zowen22/8.-Magic-Band/PCB/MagicBand_BarrelJack/drc_report.txt

** Drc report for MagicBand_BarrelJack.kicad_pcb **
** Created on 2026-08-13T00:49:16 **
** Report includes: Errors, Warnings **

** Found 4 DRC violations **
[starved_thermal]: Thermal relief connection to zone incomplete (layer B.Cu; 1 spokes connected to isolated island)
    Local override; error
    @(0.5000 mm, 0.5000 mm): Zone [GND] on B.Cu, priority 0
    @(26.5000 mm, 18.7200 mm): PTH pad 8 [GND] of U1
[lib_footprint_issues]: Footprint 'MountingHole_4.2mm' not found in library 'MountingHole'
    Local override; warning
    @(4.5000 mm, 34.5000 mm): Footprint MH2
[lib_footprint_issues]: Footprint 'MountingHole_4.2mm' not found in library 'MountingHole'
    Local override; warning
    @(35.0000 mm, 34.5000 mm): Footprint MH3
[lib_footprint_issues]: Footprint 'MountingHole_4.2mm' not found in library 'MountingHole'
    Local override; warning
    @(4.5000 mm, 5.0000 mm): Footprint MH1

** Found 0 unconnected pads **

** Found 0 Footprint errors **

** Ignored checks **
    - Footprint has no courtyard defined
    - Track endpoint not centered on via
    - Tuning profile track geometries
    - Footprint doesn't match symbol's footprint filters
    - Footprint component type doesn't match footprint pads

** End of Report **
