zowen22/8.-Magic-Band/1. Project Management/4. Technical Reference.md

# Technical Reference

*Last updated: 2026-08-10*

-----

## Hardware

| Component | Part | Notes |
|---|---|---|
| Microcontroller | Arduino Nano (ATmega328P) | Compact, fits in ornament; same pin numbers as Uno |
| RFID Reader | MFRC522 | SPI interface, 3.3V |
| NeoPixels | LED strip — count TBD (strip on order) | Pin 5, NEO_GRB, 5V |
| RF Transmitter | 433MHz transmitter module | Pin 8, ~$1, replaces relay entirely |
| RF Outlet | Etekcity or similar 433MHz outlet | Pre-paired before shipping; buyer plugs into wall |
| Audio | DFPlayer Mini + 8Ω 1W speaker | Pins 2/3 SoftwareSerial |
| MicroSD | Any small card | Audio file as 001.mp3 |
| Power input | 5.5mm/2.1mm panel-mount barrel jack | Mounts in ornament shell, wires to Nano VIN + GND |
| Power supply | 5V 3A wall adapter, barrel jack output | Buyer-supplied or included; standard commodity |

**One-time tooling (your bench only):**
| Component | Part | Notes |
|---|---|---|
| RF Sniffer | 433MHz receiver module | Used once to capture outlet remote codes |

## Pin Map (Nano)

| Pin | Function |
|---|---|
| 2 | DFPlayer RX (Arduino TX → player) |
| 3 | DFPlayer TX (player TX → Arduino) |
| 4 | MFRC522 SS |
| 5 | NeoPixel LED strip |
| 6 | *(unused — was inner ring, removed 2026-08-06)* |
| 8 | RF transmitter DATA |
| 9 | MFRC522 RST |
| 11 | SPI MOSI |
| 12 | SPI MISO |
| 13 | SPI SCK |
| 3V3 | MFRC522 VCC |
| VIN | Barrel jack center (positive) |
| GND | Barrel jack sleeve + common ground |

## Libraries

| Library | Purpose | Install via |
|---|---|---|
| MFRC522 | RFID reader | Library Manager |
| Adafruit NeoPixel | LED rings | Library Manager |
| rc-switch (sui77) | 433MHz RF transmit/receive | Library Manager |
| DFRobotDFPlayerMini | Audio player | Library Manager |
| SoftwareSerial | DFPlayer serial | Built-in |
| SPI | RFID SPI bus | Built-in |

## Sketches

| File | Purpose |
|---|---|
| `Revisions/Sniffer/Sniffer.ino` | One-time: captures RF codes from outlet remote over Serial |
| `Revisions/Rev3/Rev3.ino` | Relay-based version (archived — superseded by Rev4) |
| `Revisions/Rev4/Rev4.ino` | **Current production sketch** — RF transmitter, no mains wiring |
| `MAGIC_BAND_FINAL/` | Original working sketch (archived reference) |

## Enclosure Notes

- Ornament shell: 3D printed
- Barrel jack: 5.5mm/2.1mm panel-mount, requires **11mm hole** in shell
- Orient jack on bottom — cable exits downward, follows ornament wire naturally
- Minimum 15mm clearance behind jack inside shell for solder tabs + wiring
- Nano footprint: 18mm × 45mm — plan mounting accordingly

## RF Workflow (per unit)

1. Run `Sniffer.ino` with receiver on pin 2 — press all remote buttons, record codes
2. Fill `RF_CODE_ON`, `RF_CODE_OFF`, `RF_BITS`, `RF_PROTOCOL` in Rev4
3. Flash Rev4, put outlet in learn mode, scan any RFID card to pair
4. Confirm outlet responds, ship pre-paired

## Known Constraints / Gotchas

- Nano VIN accepts 7–12V regulated but 5V works fine from a regulated supply
- MFRC522 is 3.3V — use Nano's 3V3 pin, not 5V
- DFPlayer audio file must be named `001.mp3` on the SD card root
- rc-switch `send()` is blocking — NeoPixel animations must complete before RF fires
- 433MHz is fire-and-forget (no ACK) — send code 5× to ensure reception (`RF_REPEAT`)
- Nano has Mini-USB for programming; power in production via VIN barrel jack

## Dev Environment Setup (WSL2 + Windows) — Full Recovery Runbook

If this WSL2 instance ever gets nuked, or you're setting up on a new machine, this is
the complete path from nothing to "flashing sketches from a WSL terminal." Assumes
Windows + WSL2/Ubuntu already installed — that part isn't covered here.

### 0. Checklist (tick off in order)

- [ ] Repo cloned into WSL via SSH (not HTTPS, not the Windows filesystem)
- [ ] `arduino-cli` installed + on PATH
- [ ] `arduino:avr` core installed
- [ ] Required libraries installed (MFRC522, Adafruit NeoPixel, rc-switch, DFRobotDFPlayerMini)
- [ ] `usbipd-win` installed on Windows
- [ ] `usbip` client tools + `dialout` group set up in WSL
- [ ] Board attached (`usbipd attach`) and visible (`arduino-cli board list`)
- [ ] KiCad installed (AppImage, extracted, `kicad-cli` on PATH)
- [ ] Global symbol/footprint library tables configured (one-time GUI first-launch step)

### 1. Repo access (SSH)

Repo is `git@github.com:zowen22/8.-Magic-Band.git` — SSH only. If this WSL instance
doesn't already have a deploy key set up on your GitHub account:
```bash
ssh-keygen -t ed25519 -C "zowen22@gmail.com"   # accept default path, empty passphrase is fine for a dev box
cat ~/.ssh/id_ed25519.pub                       # paste this into GitHub → Settings → SSH keys
ssh -T git@github.com                           # should greet you by username once the key's added
```
Then clone:
```bash
mkdir -p ~/projects && cd ~/projects
git clone git@github.com:zowen22/8.-Magic-Band.git "8.-Magic-Band"
```

### 2. Arduino toolchain

```bash
mkdir -p ~/.local/bin
curl -fsSL https://raw.githubusercontent.com/arduino/arduino-cli/master/install.sh | BINDIR=~/.local/bin sh
echo 'export PATH="$HOME/.local/bin:$PATH"' >> ~/.bashrc
export PATH="$HOME/.local/bin:$PATH"          # for the current shell too

arduino-cli config init
arduino-cli core update-index
arduino-cli core install arduino:avr

arduino-cli lib install "MFRC522" "Adafruit NeoPixel" "rc-switch" "DFRobotDFPlayerMini"
```
Sanity check — should compile clean with no board attached:
```bash
cd ~/projects/8.-Magic-Band
arduino-cli compile --fqbn arduino:avr:nano:cpu=atmega328old RF_Sniffer
```

### 3. USB passthrough (Windows ⇄ WSL2)

The board connects via USB to Windows and is **not** visible in WSL by default — needs
a bridge every time it's (re)connected.

**One-time, Windows (Admin PowerShell):**
```powershell
winget install usbipd
```

**One-time, WSL (regular interactive terminal — needs real sudo):**
```bash
sudo apt-get update
sudo apt-get install -y linux-tools-generic hwdata
sudo update-alternatives --install /usr/local/bin/usbip usbip /usr/lib/linux-tools/*-generic/usbip 20
sudo usermod -aG dialout $USER
```
After `usermod`, open a **new** terminal window — group membership doesn't apply
retroactively to the shell you ran it from (`newgrp dialout` also works if `newgrp`
happens to be installed; wasn't on this machine's minimal Ubuntu image, so a fresh
terminal was the actual fix used).

**Every time the board is (re)connected, or after a reboot — Windows (Admin PowerShell):**
```powershell
usbipd list                    # find the board's BUSID
usbipd bind --busid <BUSID>    # one-time per device, not per session
usbipd attach --wsl --busid <BUSID>
```
Our board enumerates as CH340, VID:PID `1a86:7523`. Keep that PowerShell window open —
the attach only holds while it's running (or use `usbipd attach -a` for auto-reattach).

**Then, WSL:**
```bash
arduino-cli board list   # should show /dev/ttyUSB0 once attached
```

### 4. Quick-reference commands

```bash
cd ~/projects/8.-Magic-Band/<sketch-folder>          # e.g. MagicBand_Wireless, RF_Sniffer, RF_TX_Test, MagicBand_v1
arduino-cli compile --fqbn <fqbn> .
arduino-cli upload -p /dev/ttyUSB0 --fqbn <fqbn> .
arduino-cli monitor -p /dev/ttyUSB0 -c baudrate=9600
```
FQBNs in use on this project:
| Board | FQBN |
|---|---|
| Nano (old bootloader — the spare bench board) | `arduino:avr:nano:cpu=atmega328old` |
| Pro Mini, 5V/16MHz (real wireless-variant target) | `arduino:avr:pro:cpu=16MHzatmega328` |

### 5. KiCad (PCB design)

No root/apt available in this sandbox — installed via the official AppImage, extracted
manually (no FUSE), not run in place.

```bash
mkdir -p ~/.local/opt && cd ~/.local/opt
# grab the current AppImage from https://www.kicad.org/download/linux/ — 10.0.5 is what's installed here
chmod +x kicad-10.0.5-x86_64.AppImage
./kicad-10.0.5-x86_64.AppImage --appimage-extract        # produces ./squashfs-root

mkdir -p ~/.local/bin
ln -s ~/.local/opt/squashfs-root/usr/bin/kicad-cli ~/.local/bin/kicad-cli
echo 'export PATH="$HOME/.local/bin:$PATH"' >> ~/.bashrc  # skip if already added in step 2
```
Launch the GUI — appears via WSLg automatically, no X server setup needed, **but force
software rendering** (see gotcha below, confirmed 2026-08-05):
```bash
LIBGL_ALWAYS_SOFTWARE=1 ~/.local/opt/squashfs-root/usr/bin/kicad
```
**First launch does one-time global library setup** — this is a real GUI-only step
(tracked as WP3.1, can't be done headlessly). KiCad will prompt to configure the global
symbol and footprint library tables; accept the defaults. Despite this being the "lite"
AppImage variant, both `usr/share/kicad/symbols` and `usr/share/kicad/footprints` **are**
bundled locally under `~/.local/opt/squashfs-root/` (verified 2026-08-05 — earlier notes
in this project claiming "no bundled footprint library" were wrong; no network fetch is
needed for standard parts).

`pymupdf` (Python) is already available in this environment, no separate install needed —
used to render datasheet PDFs to images locally for pin-diagram verification when
`poppler-utils`/`pdftoppm` isn't available (root-blocked, same constraint as everything
else here).

### 6. FreeRouting (autorouter)

Runs headless once you have a Specctra DSN file — but two steps around it are GUI-only in
KiCad 10.0.5 (no `kicad-cli` equivalent exists for either):
1. **DSN export**: `pcbnew` → File → Export → Specctra DSN
2. **Session re-import**: `pcbnew` → File → Import → Specctra Session (then **Fill Zones**
   again — the copper pour doesn't auto-recompute against newly-imported tracks/vias, and
   DRC will show a wave of bogus `0.0000mm` clearance violations until you refill)

**Setup (one-time):**
```bash
mkdir -p ~/.local/opt
# freerouting.jar (v2.2.4): https://github.com/freerouting/freerouting/releases
# needs a JRE with class file version >= 69 (Java 25) -- confirmed the error otherwise:
#   UnsupportedClassVersionError: ... compiled by a more recent version ...
# a JDK 17 JRE will NOT work. Grab a JDK 25 JRE (e.g. Eclipse Temurin) and extract to
# ~/.local/opt/jre25/
```
Both files must live under `~/.local/opt/` (or somewhere else persistent) — **not** `/tmp`,
which is ephemeral in this environment and won't survive a reboot/reset.

**Run:**
```bash
~/.local/opt/jre25/jdk-25.0.4+7-jre/bin/java -jar ~/.local/opt/freerouting-2.2.4.jar \
  -de "<board>.dsn" \
  -do "<board>.ses" \
  -mp 50 \
  --gui.enabled=false
```
`-de` = design (input DSN), `-do` = design output (session file), `-mp` = max passes.
Config/logs land in `/tmp/freerouting/` (`freerouting.json`, `freerouting.log`) — that's
FreeRouting's own default (`java.io.tmpdir`), fine to leave ephemeral, only the jar+JRE
need to persist. On the 40x40mm 2-layer board here: 42 unrouted nets → 0, 4 passes, ~2.5s.

**Gotcha (confirmed 2026-08-10):** despite running via CLI args, FreeRouting can still pop
up a GUI dialog (data-collection/review consent) when a display is reachable (WSLg here) —
this silently blocks the process between "routing complete" and actually writing the `.ses`
file, no CLI error, just a multi-minute hang until someone dismisses the popup by hand.

First attempted fix — editing `/tmp/freerouting/freerouting.json` to set
`gui.enabled`/`allow_telemetry`/`allow_contact` to `false` — **didn't hold**: the popup
itself writes its own values back to that file (GUI source, priority 50 in FreeRouting's
own settings-precedence ladder — see `docs/settings.md` in the freerouting repo), so it
silently reverted between runs. **The reliable fix is the `--gui.enabled=false` CLI flag**
shown above (priority 60, always beats the file and any GUI write-back). Always pass it
explicitly on every invocation rather than relying on the JSON file's persisted state.

### 7. Placement & Routing Workflow (end-to-end)

The full cycle used repeatedly on 2026-08-09/10, split by who does which half:

1. **User, in `pcbnew`:** move/place components as needed.
2. **User:** if the move was substantial (moved something that already had routing near
   it), select-all tracks/vias with the Selection Filter set to Tracks+Vias only, delete,
   then **Fill Zones (B)**. For a small/isolated move this step can often be skipped —
   FreeRouting will just re-route whatever's now broken and leave the rest alone.
3. **User:** File → Export → Specctra DSN, overwrite `<board>.dsn` in the same folder.
4. **User:** tell Claude "exported" (or similar).
5. **Claude:** run FreeRouting (see section 6 above for the exact command, always with
   `--gui.enabled=false`). Report the unrouted-net count before/after.
6. **User:** File → Import → Specctra Session, then **Fill Zones (B)** again (the pour
   doesn't auto-recompute against newly-imported copper), then save.
7. **Claude:** run `kicad-cli pcb drc`, regenerate `board_top.svg`/`board_bottom.svg`,
   commit + push to `main`, update Work Packages/Session Log.

**When FreeRouting can't finish some nets** (stalls at N unrouted, "board state has not
changed... cannot make further progress"): don't fight it with more passes, just finish
those specific nets by hand in `pcbnew` — usually faster and it's exactly what interactive
routing is for:
- Press **X** on a pad/net to start an interactive route, click to lay down segments.
- Press **V** *while still actively dragging* to drop a via and hop to the other copper
  layer at that point — the standard way around an obstacle on the current layer.
- To change an **existing** trace: select it and press **G** (drag, keeps connections
  intact — not **M**, which is a bare move and leaves the trace behind) then **V** mid-drag
  to hop layers, or for a trace whose both ends already land on a via/THT pad, just
  right-click → **Properties** and change the **Layer** field directly, no via needed.
- After a manual fix, re-export DSN and run FreeRouting again if you want it to pick up
  and finish anything else — it treats already-routed nets as done and only works on what's
  left (confirmed 2026-08-10: a re-run after a manual fix reported "started with 0 unrouted
  nets" and exited immediately).

**If a Specctra session import ever comes back corrupted/fails**, don't fight it: revert
the uncommitted `.kicad_pcb` (`git restore` back to the last commit, or File → Revert in
`pcbnew`) rather than trying to debug a broken `.ses` — cheaper to redo the move and
re-export than to chase corruption. Delete the stale `.dsn`/`.ses` too so there's no
confusion about which export is current.

### Dead ends — don't retry these

- **Launching KiCad under WSLg with default (hardware) OpenGL rendering** — symptom:
  window opens but appears frozen/unresponsive, and hovering over it makes the mouse
  cursor disappear entirely; clicks don't register. This is a WSLg GPU-passthrough
  rendering glitch (KiCad's canvas uses OpenGL, passed through to the Windows host GPU
  driver via WSLg's virtual GPU layer), not an app hang — confirmed by killing and
  relaunching with `LIBGL_ALWAYS_SOFTWARE=1`, which fixed it immediately (2026-08-05).
  **Always launch KiCad with that env var set** (see launch command above) until this is
  root-caused properly — likely candidates if it needs a permanent fix: `wsl --update`
  from an admin Windows PowerShell, or a Windows-side GPU driver update. Software
  rendering is slower but fine for a 40x40mm board.
- **Using "Update PCB from Schematic" (F8) on `MagicBand_BarrelJack`** — confirmed broken:
  the board's PCB footprints are missing the `path` attribute that links them back to their
  schematic symbol's UUID (likely from earlier direct `.kicad_pcb`/`.kicad_sch` S-expression
  edits that bypassed the normal netlist-import flow — see the placement-fix and J7-removal
  entries in `5. Session Log.md`). Without that link, F8 can't recognize any existing PCB
  footprint as already-placed, so it treats every schematic symbol as new and adds a
  duplicate footprint for each one, right on top of the originals (confirmed 2026-08-10,
  reverted without saving). For any future footprint swap on this board, use PCB-side
  **Change Footprint(s)...** directly (select the footprint, right-click) instead — it
  doesn't depend on the broken schematic linkage. F8 also first requires the schematic be
  annotated (Tools → Annotate Schematic, "keep existing annotations") even though every
  symbol already has a normal numbered reference — that's a separate, harmless prerequisite
  check, not related to the duplication bug.
- **Expecting a `pcbnew` Python module in this AppImage install** — confirmed absent (not
  assumed). Headless PCB scripting is limited to `kicad-cli`'s DRC/ERC/export subcommands
  plus direct `.kicad_pcb`/`.kicad_sch` S-expression text editing — no programmatic
  board-object API here.
- **Expecting `kicad-cli` to export Specctra DSN for autorouting** — not present in KiCad
  10.0.5; that export is GUI-only (`File → Export → Specctra DSN`). FreeRouting itself
  runs fine headless (portable JRE, no root needed), but there's no way to hand it a board
  without the GUI export step first. See "FreeRouting (autorouter)" above for the working
  headless recipe once you have a DSN in hand.
- **Running FreeRouting with whatever `java` happens to be on PATH** — this jar needs a
  JDK 25+ JRE specifically; anything older (confirmed: JDK 17) fails immediately with
  `UnsupportedClassVersionError`. See "FreeRouting (autorouter)" above.
- **Mapping `\\wsl$\...` as a network drive** (`net use`, `New-PSDrive -Persist`,
  Explorer's "Map Network Drive" wizard) — all fail with "network name no longer
  available," or loop on a credential prompt that goes nowhere. The share works fine for
  *browsing* in Explorer or passing a raw UNC path as a CLI argument — just not for
  persistent drive mapping.
- **Opening sketches in Arduino IDE via a `\\wsl$\...` path** — the IDE's file-open
  dialog silently creates a blank `sketch_xxxx` instead of loading the real file, even
  when the dialog itself accepted the path. Legacy Windows file APIs mishandling UNC
  paths, not a content problem. Drag-and-drop from an open Explorer window onto the IDE
  window works around it; better to just skip the IDE GUI entirely (step 4 above).
- **Doing any of this from a Claude Code background job** — those run in a locked-down
  container with its own synthetic `/dev` that doesn't include real hardware, even after
  a successful `usbipd attach`. The kernel genuinely does bind the board (visible in the
  WSL2 VM's own `dmesg`), but the job's container can't see it, and there's no
  permission or sudo that changes that — it's a mount-namespace boundary, not an access
  grant. Needs a real interactive WSL terminal, opened by you, not a background job.
