zowen22/8.-Magic-Band/PCB/MagicBand_BarrelJack/schematic.pdf

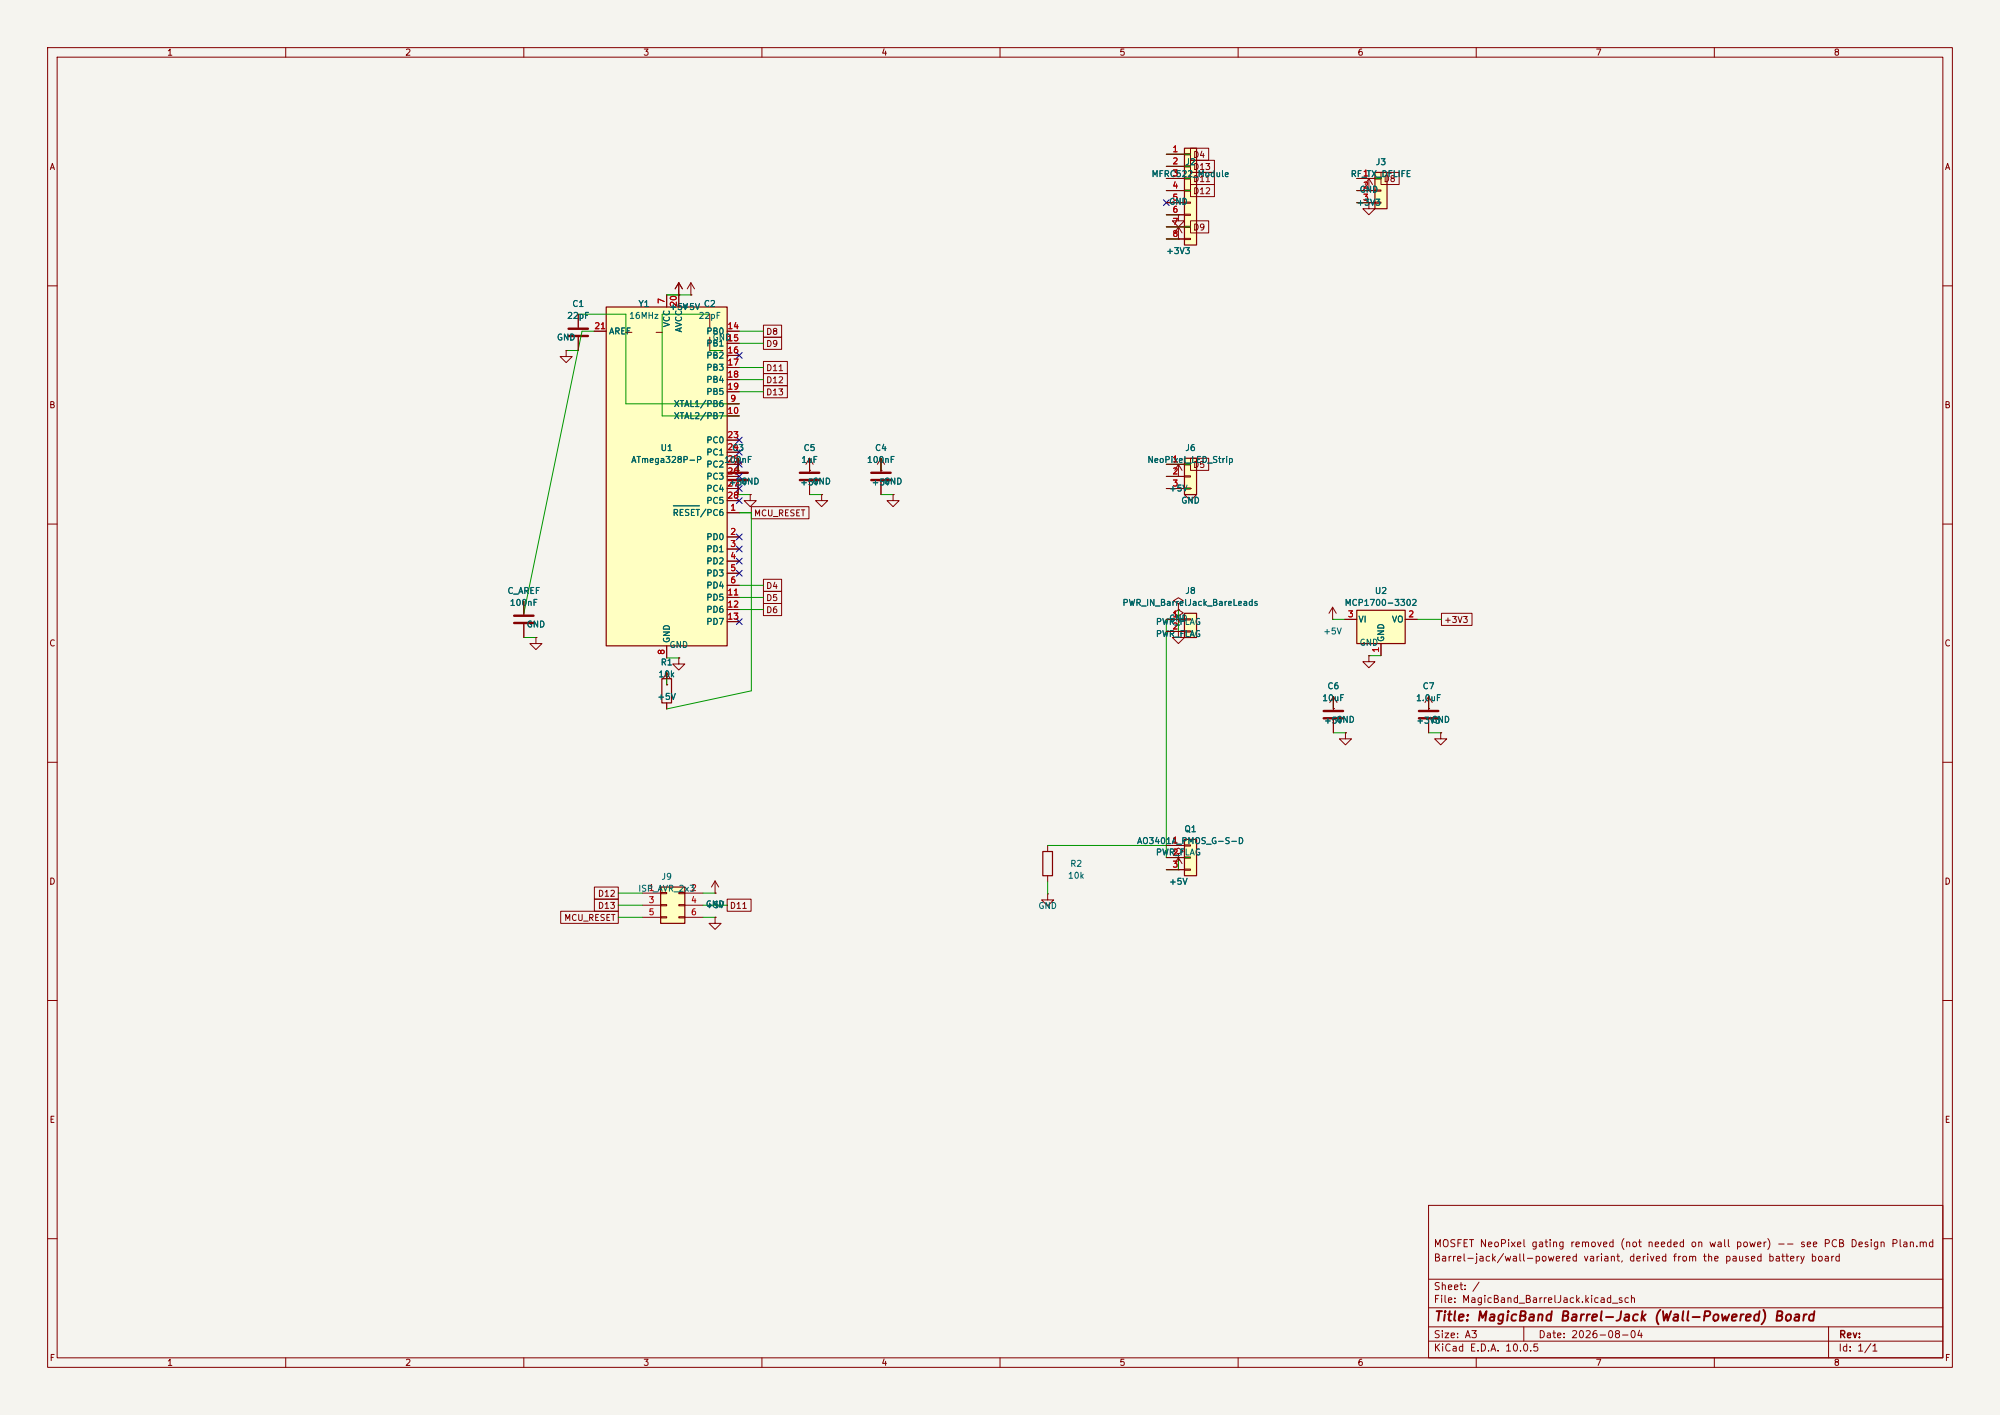
[picture p1: page 1]

MOSFET NeoPixel gating removed (not needed on wall power) -- see PCB Design Plan.md
Barrel-jack/wall-powered variant, derived from the paused battery board

Sheet: /
File: MagicBand_BarrelJack.kicad_sch
Title: MagicBand Barrel-Jack (Wall-Powered) Board

Size: A3 | Rev: | F Date: 2026-08-04
KiCad E.D.A. 10.0.5 | Id: 1/1
