zowen22/8.-Magic-Band/PCB/MagicBand_FullyCustom/schematic.pdf

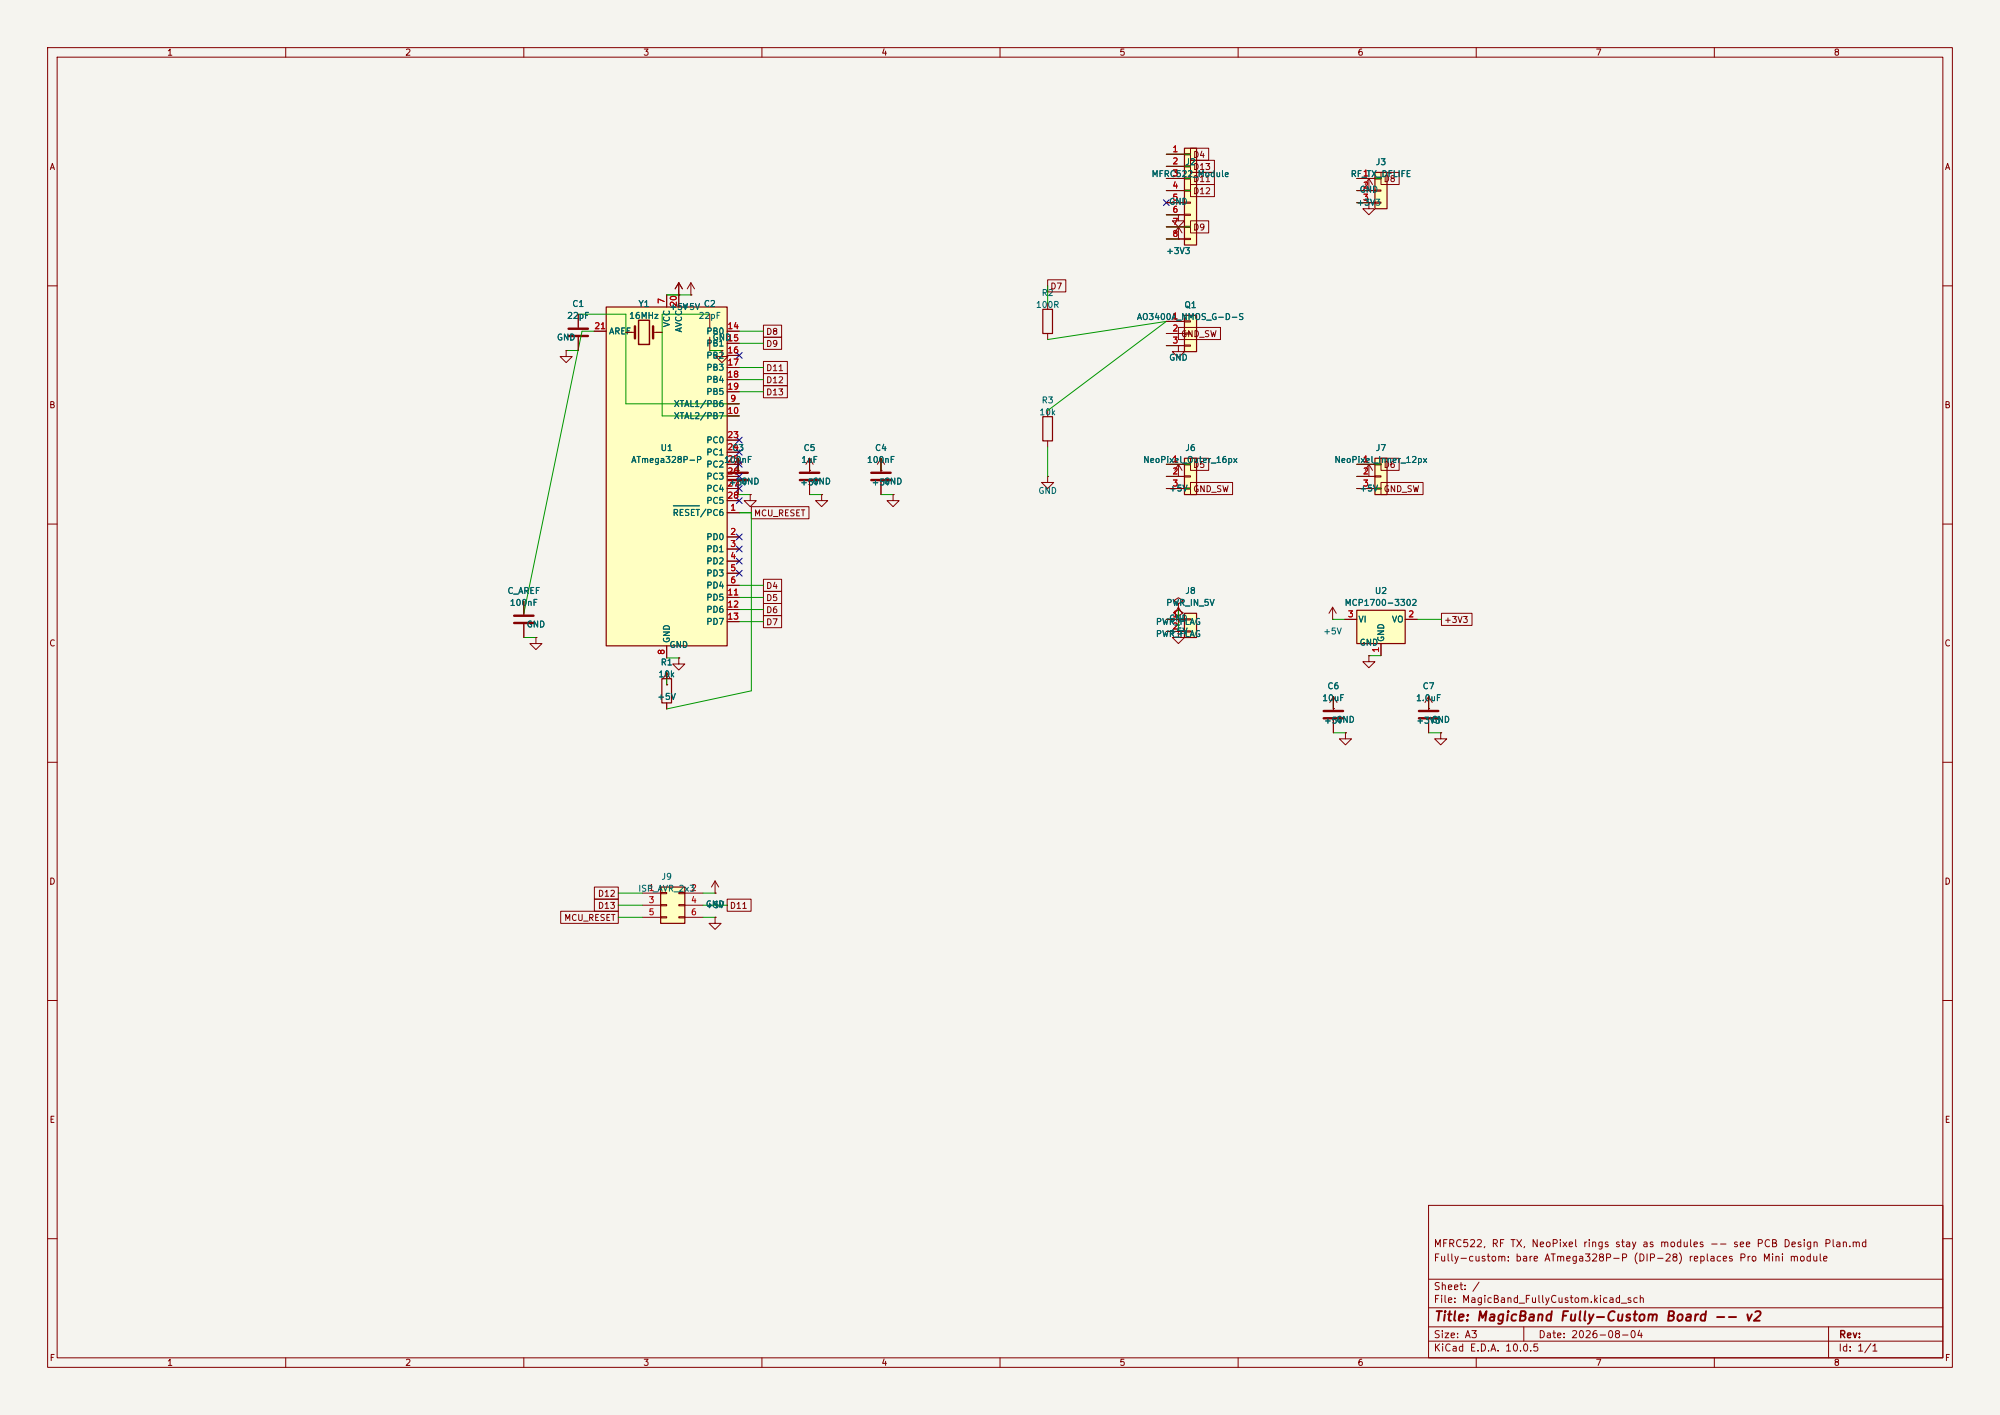
[picture p2: page 1]

MFRC522, RF TX, NeoPixel rings stay as modules -- see PCB Design Plan.md
Fully-custom: bare ATmega328P-P (DIP-28) replaces Pro Mini module

Sheet: /
File: MagicBand_FullyCustom.kicad_sch
Title: MagicBand Fully-Custom Board -- v2

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
