zowen22/8.-Magic-Band/PCB/MagicBand_Carrier/schematic.pdf

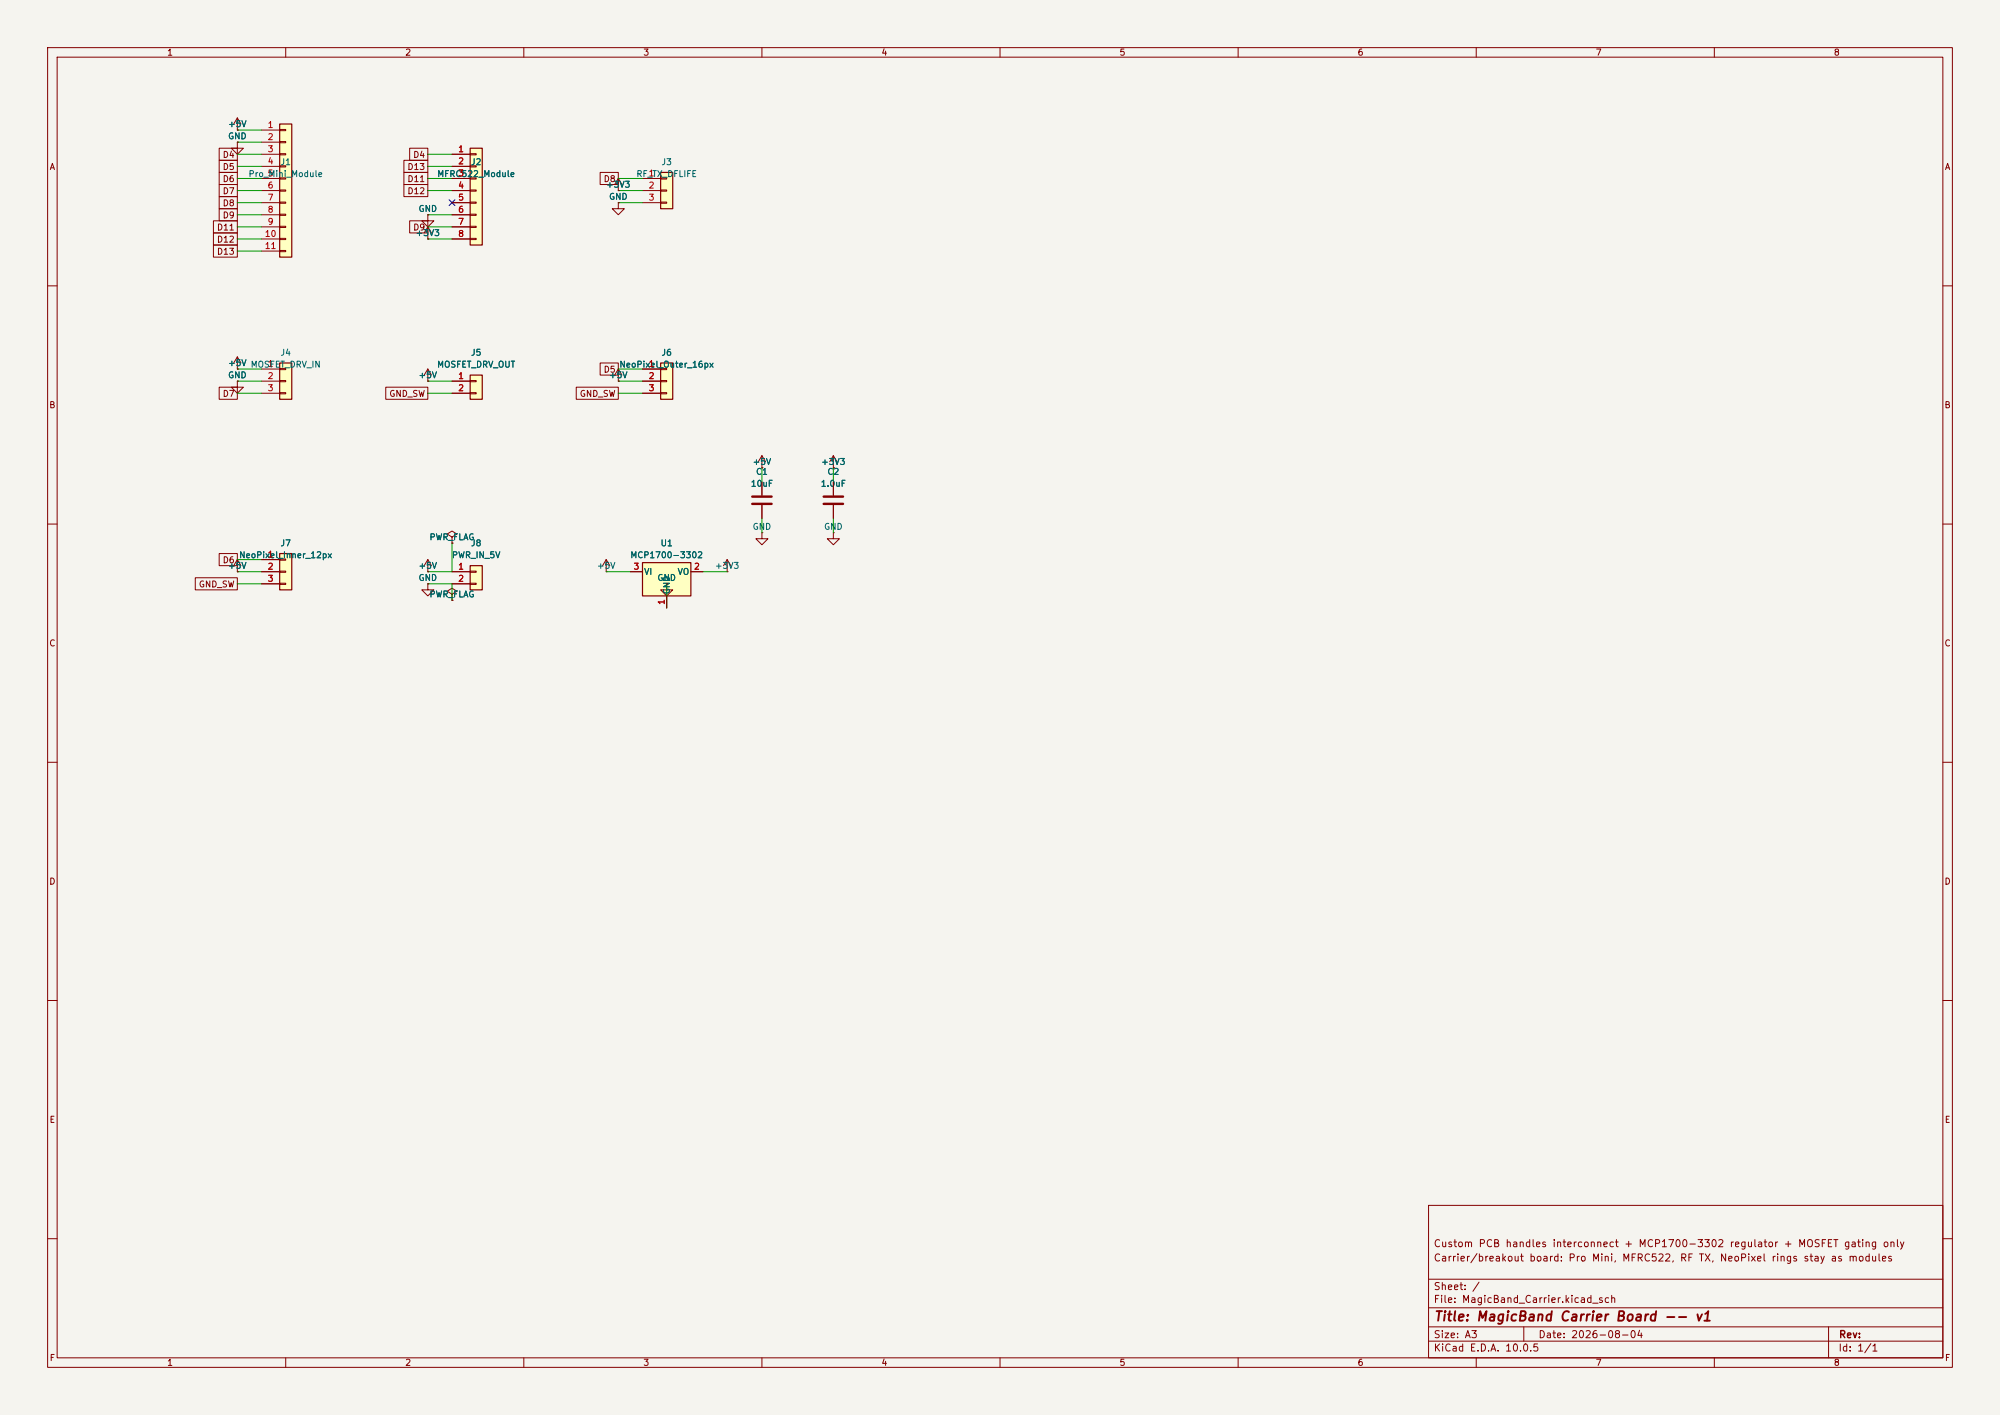
[picture p3: page 1]

Custom PCB handles interconnect + MCP1700-3302 regulator + MOSFET gating only
Carrier/breakout board: Pro Mini, MFRC522, RF TX, NeoPixel rings stay as modules

Sheet: /
File: MagicBand_Carrier.kicad_sch
Title: MagicBand Carrier Board -- v1

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
