zowen22/8.-Magic-Band/PCB/MagicBand_BarrelJack/MagicBand_BarrelJack.kicad_pcb

## KiCad design PCB/MagicBand_BarrelJack/MagicBand_BarrelJack.kicad_pcb (2026-08-13)

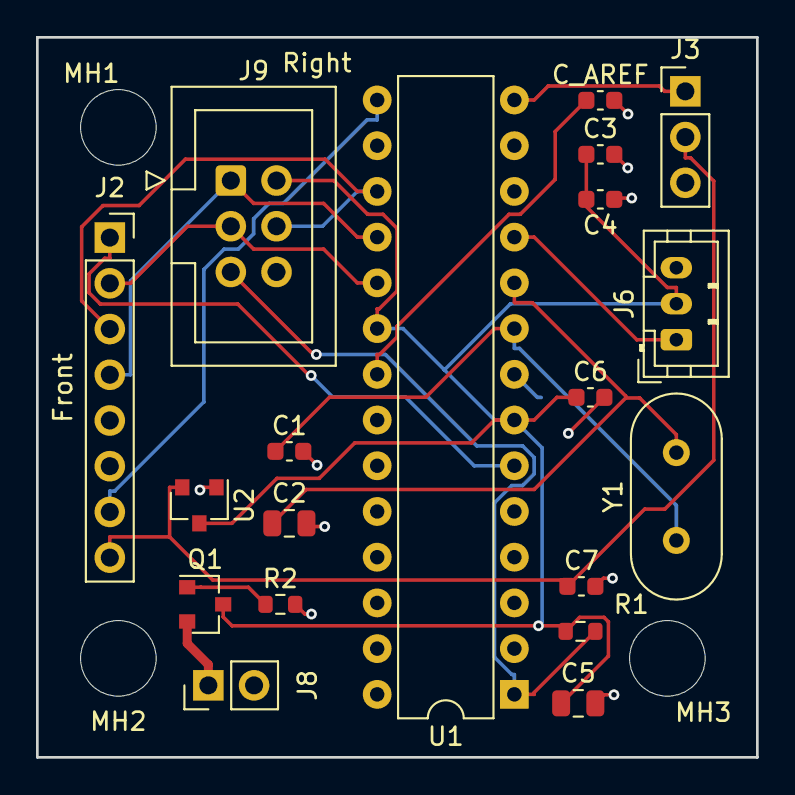
[picture p4: board MagicBand_BarrelJack.kicad_pcb from above]

Board: 2 copper layers, 40.0 x 40.0 mm, 22 parts (0 on the bottom side), 16 nets.

Parts:
C1, C3, C4, C6, C7: C_0603_1608Metric
C2, C5: C_0805_2012Metric
C_AREF: C_0603_1608Metric
J2: PinSocket_1x08_P2.54mm_Vertical
J3: PinHeader_1x03_P2.54mm_Vertical
J6: JST_PH_B3B-PH-K_1x03_P2.00mm_Vertical
J8: PinHeader_1x02_P2.54mm_Vertical
J9: IDC-Header_2x03_P2.54mm_Vertical
MH1, MH2, MH3: MountingHole_4.2mm
Q1: SOT-23
R1, R2: R_0603_1608Metric
U1: DIP-28_W7.62mm
U2: SOT-23
Y1: Crystal_HC49-4H_Vertical

Connections:
+3V3: C7.1, J2.8, J3.2, U2.2
+5V: C3.1, C4.1, C5.1, C6.1, J6.2, J9.2, Q1.3, R1.1, U1.7, U1.20, U2.3
D4: J2.1, U1.6
D5: J6.1, U1.11
D8: J3.1, U1.14
D9: J2.7, U1.15
D11: J2.3, J9.4, U1.17
D12: J2.4, J9.1, U1.18
D13: J2.2, J9.3, U1.19
GND: C1.2, C2.2, C3.2, C4.2, C5.2, C6.2, C7.2, C_AREF.2, J2.6, J3.3, J6.3, J8.2, J9.6, R2.2, U1.8, U1.22, U2.1
MCU_RESET: J9.5, R1.2, U1.1
unnamed: J8.1, Q1.2
unnamed: Q1.1, R2.1
unnamed: C_AREF.1, U1.21
unnamed: C1.1, U1.9, Y1.1
unnamed: C2.1, U1.10, Y1.2
