zowen22/8.-Magic-Band/(commit log)

2026-06-16 Add Disney MagicBand Arduino project files
    - MAGIC_BAND_FINAL/: final version
    - MagicBand/: main working sketch
    - Revisions/: Rev1, Rev1Backup, Rev2
    Sourced from OneDrive > 4. Arduino Projects > Disney Magicband
2026-06-16 PM kickoff: problem statement, overview, WPs, tech ref, session log
    Code audit complete — 8 bugs documented in Technical Reference.
    Rev3 rewrite planned next session.
2026-06-16 Rev3: clean rewrite — all bugs fixed, audio re-integrated
    - NUMPIXELS_OUTER / NUMPIXELS_INNER at top: easy to adjust per hardware
    - for-loops and fill() replace ~200 lines of verbose setPixelColor calls
    - toggleRelay() helper eliminates duplicated relay logic
    - treeOn boolean replaces confusing counter parity
    - DFPlayer moved to pins 2 & 3; RFID SS to pin 4 — zero pin conflicts
    - rainbowCycle() fixes infinite loop bug and uninitialized j
    - Wheel() replaced with ColorHSV (cleaner, correct for both rings)
    - PICC_HaltA / StopCrypto1 restored at end of scan
2026-06-16 Add Sniffer + Rev4: relay replaced with 433MHz RF transmitter
    Sniffer.ino: prints RF codes from outlet remote over Serial.
    Run once to capture codes, fill into Rev4 constants.
    Rev4.ino: production sketch
    - RF transmitter on pin 8 replaces relay entirely (no mains wiring)
    - RF_CODE_ON / RF_CODE_OFF placeholders at top — fill after sniffing
    - Sends code RF_REPEAT (5) times per toggle for reliability
    - All Rev3 improvements preserved (pixel vars, treeOn bool, clean loops)
2026-06-16 Nano, barrel jack, RF outlet — architecture finalized
    - Rev4 header updated: Nano pinout, barrel jack power note, 3V3 for MFRC522
    - Technical Reference: full BOM, pin map, enclosure notes, RF workflow
    - Project Overview decisions log: RF outlet, Nano, barrel jack rationale
    - Session log: next actions updated
2026-06-24 Update CLAUDE.md from project framework template
    Syncs with latest template: dynamic audit/plan discovery, new WP
    conventions, session log format, memory vs PM files guidance, and
    PM improvement suggestion workflow.
    Claude-Session: https://claude.ai/code/session_01Njf8pFLyvcCLYUwnAMmZwV
2026-06-24 Remove old Arduino iterations, keep MAGIC_BAND_FINAL
    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
2026-06-24 Rename to MagicBand_v1, adapt for LED strip rings
    - Rename MAGIC_BAND_FINAL → MagicBand_v1 (version-iteration convention)
    - Replace outerRing/innerRing defines (OUTER_LEDS/INNER_LEDS) — single
    value to change when cutting strips to a new length
    - Replace pixel-by-pixel disneyoff/disneyaccess with ledsOff()/ledsAccess()
    using fill() and numPixels() loops — strip-length agnostic
    - Replace hardcoded disney() spin with spinAnimation() loop (original
    addressed pixels 11-19 on an 11-LED ring; silently ignored but wrong)
    - Extract toggleRelay() to eliminate duplicated relay logic
    - Fix rainbow2() to drive each ring independently at correct pixel count
    - Remove dead code: test(), rainbow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
    [MagicBand_v1.ino]
2026-06-24 Firmware audit: fix critical bugs, clean up code quality
    Critical:
    - Fix while(!Serial) — device hung in standalone (no USB host)
    - Move DFPlayer to D2/D3; was on D10/D11, conflicting with MFRC522 SPI
    - Guard player.play() with playerReady flag
    Quality:
    - Remove String content (unused, heap fragmentation risk)
    - Remove dead resetFunc
    - Extract readGuestName() so RFID halt always runs on all exit paths
    - Consolidate buffer1/buffer2 into one buffer
    - Remove PICC_DumpDetailsToSerial() verbose noise from main flow
    - Wrap string literals in F() macro (saves ~50 bytes RAM on Nano)
    - Fix include style, const uint8_t pins, scanCount init, 65536L suffix
    - Remove dead card-detect in rainbow(), dead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
    [MagicBand_v1.ino]
2026-07-07 Add BOM for battery-powered wireless ornament variant
    Documents an alternate build that untethers the ornament from wall
    power (LiPo + PowerBoost 1000C USB-C charging) alongside the existing
    wired-build BOM in Technical Reference. Flags open assumptions around
    wireless scope, battery chemistry, and enclosure fit for user review.
2026-07-12 Update wireless ornament BOM: power architecture, sourced audit, pricing
    Swaps PowerBoost 1000C (out of stock) for Seeed Lipo Rider Plus, swaps
    Nano for Pro Mini to enable real duty-cycle power savings, adds MOSFET
    gating for NeoPixel idle draw, drops audio from the baseline BOM (kept
    optional in both wired and wireless docs), and rewrites the power
    budget with sourced consumption figures and two runtime scenarios.
2026-07-12 Add wireless-variant firmware, update PM docs
    Sleep/wake firmware for the Pro Mini variant (BOM's "properly engineered"
    scenario): watchdog-driven power-down sleep waking ~1Hz, MFRC522
    soft-powered up/down per poll, NeoPixel VCC MOSFET-gated off between
    animations, RF transmit via rc-switch on card scan. Compiles clean for
    both the Pro Mini and Nano FQBNs; upload-verified on a spare Nano (no
    Pro Mini on hand yet). Built on the RF-transmitter architecture per
    Technical Reference/BOM, since Rev4.ino (the RF version) was deleted
    from history and the surviving MagicBand_v1.ino is relay-based.
    Both open BOM bench-test numbers remain blocked — prototype parts
    (Pro Mini, Lipo Rider Plus) haven't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
2026-07-12 Capture RF module pinout, add Sniffer/TX bench-test sketches
    Documented the actual sourced 433MHz TX/RX modules (D-FLIFE kit) from
    listing images + a customer review — no formal datasheet exists. Key
    finding folded into the BOM and firmware comments: the TX module is
    3.3V-only, sharing the MFRC522's rail rather than the 5V bus assumed
    elsewhere.
    Added RF_Sniffer.ino (recreates the bench capture tool lost when
    Rev4/Sniffer were deleted from history) and RF_TX_Test.ino (standalone
    transmitter bench test). Both compile clean on Pro Mini and Nano;
    Sniffer flashed to the spare Nano for the user to capture real remote
    codes.
2026-08-04 Log WSL toolchain setup and compile verification session
    Flags stale local main checkout (8 behind origin) and confirms current
    sketches (MagicBand_Wireless, MagicBand_v1, RF_Sniffer, RF_TX_Test) still
    compile clean against their real target boards.
2026-08-04 Fill real RF codes into wireless firmware, document WSL/USB dev setup
    Captured top-row ON/OFF codes for the tree-lights outlet via RF_Sniffer
    (32-bit, protocol 2, ~700us pulse) and wired them into MagicBand_Wireless.ino
    and RF_TX_Test.ino, replacing placeholders. Added explicit setPulseLength()
    since the measured pulse length doesn't match rc-switch's protocol-2 default.
    Also documents the WSL2 <-> Windows USB passthrough process (usbipd, dialout
    group, dead ends around \\wsl$ drive mapping and Arduino IDE) in Technical
    Reference so it doesn't need to be re-derived next time.
    [MagicBand_Wireless.ino, RF_TX_Test.ino]
2026-08-04 Expand dev-environment doc into a full from-scratch recovery runbook
    Covers SSH repo access, arduino-cli/core/library install, and USB passthrough
    as one ordered checklist, so a nuked WSL2 instance or a new machine can get
    back to "flashing sketches from a WSL terminal" without re-deriving any of it.
2026-08-04 Log session wrap-up: recovery runbook, BOM walkthrough, direct-push workflow
2026-08-04 Add 3.3V regulator to wireless BOM for MFRC522/RF TX power
    Pro Mini has only one onboard regulator (5V) — unlike the Nano, there's no
    separate 3.3V pin to power the MFRC522 and RF TX module, both 3.3V-only
    parts. Adds an AMS1117-3.3 breakout as a BOM line item, updates the
    firmware's pin-map comment to stop implying a native Pro Mini 3.3V pin,
    and logs the decision.
2026-08-04 Fix regulator choice: MCP1700-3302, not AMS1117
    AMS1117-3.3 has a ~3-10mA quiescent current, verified against its own
    datasheet-cited specs. Fed continuously off the Pro Mini's always-on 5V
    rail, that alone would exceed the entire sleep-budget target (~1.3-1.5mA
    total). MCP1700-3302 has the same 3.3V/250mA output but 1.6uA quiescent
    current -- genuinely negligible against the budget. Same price range,
    same footprint class. Caught before ordering, not after.
    [MagicBand_Wireless.ino]
2026-08-04 Open Phase 3: custom PCB planning (KiCad, carrier/breakout approach)
2026-08-04 Add consolidated PCB Design Plan (carrier-board v1 + fully-custom v2)
    Merges both research threads into one doc: v1 carrier/breakout board
    (footprint sourcing, RF layout, JLCPCB fab/assembly options) and v2
    fully-custom bare-ATmega328P path (feasibility, component choices, why
    MFRC522/RF-TX stay as modules regardless). KiCad 10.0.5 installed via
    AppImage in this WSL environment (apt blocked, no root) with kicad-cli
    on PATH for DRC/ERC validation and rendering.
2026-08-04 Build v1 carrier-board KiCad schematic, ERC-clean
    Real schematic capture in PCB/MagicBand_Carrier/ (KiCad 10.0.5, via
    kicad-cli, no GUI) implementing Stage 1 of the PCB Design Plan: Pro Mini,
    MFRC522, RF TX module, MOSFET driver in/out, NeoPixel outer/inner headers,
    5V power input, and the MCP1700-3302 regulator with decoupling caps, wired
    per MagicBand_Wireless.ino's pin map. ERC: 0 errors, 120 benign warnings
    (grid-alignment cosmetics + missing project-level library-table config,
    non-blocking since all symbols are embedded).
    Three coordinate-system bugs found and fixed while building this, logged
    in Session Log for next time: embedded lib_symbols entries must be
    qualified as "LibraryNickn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
    [MagicBand_Carrier.kicad_sch]
2026-08-04 Fix undersized MCP1700 decoupling caps per Microchip datasheet
    Independent review (separate from the agent that built the schematic)
    found C1/C2 both at 100nF. Microchip's DS20001826 specifies 1.0uF as the
    standard/minimum output cap for stability -- undersized output
    capacitance risks oscillation, and the MFRC522's active-scan current
    step (13-26mA) is exactly the kind of load transient that stresses that
    margin. C2 (output) -> 1.0uF per datasheet, C1 (input) -> 10uF per
    typical reference-design sizing. Re-ran ERC: still 0 errors, same 120
    cosmetic warnings.
    v2 (PCB/MagicBand_FullyCustom/) doesn't exist yet -- needs the same fix
    once it lands.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
    [MagicBand_Carrier.kicad_sch]
2026-08-04 Build v2 fully-custom (bare ATmega328P) KiCad schematic, ERC-clean
    Replaces v1's Pro Mini header with a bare ATmega328P-P (DIP-28) circuit:
    crystal+load caps, VCC/AVCC decoupling, AREF decoupling, RESET pull-up,
    6-pin AVR ISP header sharing SPI lines with MFRC522. MFRC522/RF TX/MOSFET
    driver/NeoPixel headers/5V input/MCP1700 regulator carried over from v1
    unchanged, including v1's independent-review decoupling fix (10uF/1.0uF).
    0 ERC errors, 206 cosmetic warnings (same categories as v1). Netlist
    independently verified against design intent, not just ERC-clean -- all
    Arduino-to-ATmega pin mappings and every net checked directly.
    Found and fixed two non-obvious kicad-cli bugs along the way,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
    [MagicBand_FullyCustom.kicad_sch]
2026-08-04 Fix MOSFET driver connector footprint mismatch (JST-PH, not 2.54mm header)
    Component-selection audit caught this: Adafruit MOSFET Driver (PID 5648)
    uses a single 3-pin STEMMA JST-PH connector at 2mm pitch (V+/GND/In
    together, confirmed against Adafruit's own pinout docs), not a generic
    2.54mm/0.1" pin header. The two aren't physically compatible -- the real
    cable would not have mated with what was drawn. Swapped J4's footprint to
    JST_PH_B3B-PH-K_1x03_P2.00mm_Vertical, confirmed against KiCad's official
    footprint repo. ERC re-run clean, no regression (0 errors, same 206
    warnings).
    Lipo Rider Plus's 5V output connector (J8) is flagged as still unverified
    -- its 5V rail appears to route throug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
    [MagicBand_FullyCustom.kicad_sch]
2026-08-04 Log component-selection audit findings (JST-PH fix, Lipo Rider Plus open question)
2026-08-04 WIP: partial v2 PCB layout, NOT DRC-clean -- stopped to save credits
    Layout fork was stopped mid-debugging before finishing. Preserving its
    progress rather than losing it, but this is NOT a validated layout:
    58 real DRC errors remain (34 clearance overrides, 24 solder-mask-width
    violations), plus 1 warning. Do not treat this .kicad_pcb as ready for
    fab prep or ordering -- placement/routing still needs real completion
    and a clean DRC pass before that.
    [MagicBand_FullyCustom.kicad_pcb]
2026-08-04 Integrate MOSFET switch circuit directly into v2 schematic
    Replaces the external Adafruit MOSFET driver module (J4/J5, JST-PH
    connector) with an on-board MOSFET switch: Q1 (N-channel logic-level
    MOSFET, e.g. AO3400A/SOT-23), R2 (100R gate series resistor), R3 (10k
    gate pull-down for a defined-off startup state before firmware drives
    D7). Same low-side-switching topology as before -- verified via the
    exported netlist, not just ERC, that NeoPixel headers J6/J7 still tie to
    GND_SW correctly through Q1's drain.
    Deliberate scope call, not a mistake fix: unlike the RFID/RF modules
    (real antenna engineering, stay external by design), a MOSFET switch is
    basic circuit design worth integrating direct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
    [MagicBand_FullyCustom.kicad_pcb, MagicBand_FullyCustom.kicad_sch]
2026-08-04 Pause battery-powered wireless variant, pivot to barrel-jack power
    LiPo batteries carry real shipping/hazmat friction (UN38.3, carrier rules)
    and marketplace listing restrictions (Etsy) if this becomes a sellable
    product. Archiving the wireless-variant work in place rather than deleting
    it -- BOM and PCB Design Plan marked PAUSED with reasoning, Decisions Log
    updated, Work Packages' wireless/PCB sections marked paused with a new
    Phase 4 stub opened for the barrel-jack-powered board.
    RFID/RF-TX wiring, connector-fit findings, and NeoPixel work carry
    forward regardless of power architecture; the battery-specific complexity
    (sleep/wake loop, MOSFET gating for battery life, low-quiescent regula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
2026-08-04 MFRC522 as a stacking header, not loose wires
    J2's footprint changed from a male pin header to a female socket strip
    (PinSocket_1x08_P2.54mm_Vertical) so the MFRC522 breakout's own header
    pins plug directly into the custom board -- shield-style stacking instead
    of jumper wires. Addresses the "two loose boards to mount inside the
    ornament" problem mechanically. Full chip-level MFRC522 integration was
    considered and rejected (real antenna-tuning engineering, likely needs
    re-tuning once mounted -- not worth the risk this project has been
    explicitly trying to avoid). ERC re-run clean, no regression.
    [MagicBand_FullyCustom.kicad_sch]
2026-08-04 Add barrel-jack/wall-powered board schematic, ERC-clean
    New active board (PCB/MagicBand_BarrelJack/), derived from the paused v2
    fully-custom battery schematic. Kept: ATmega328P-P circuit, MFRC522
    stacking socket, RF TX wiring, MCP1700-3302 regulator. Removed: MOSFET
    NeoPixel-gating circuit (Q1/R2/R3, GND_SW net) -- battery-life-only,
    not needed on wall power. Added: barrel jack power input, 5.5mm/2.1mm
    center-positive, per the original wired-build spec in Technical Reference.
    Caught and fixed a real bug before committing: KiCad's actual
    Connector:Barrel_Jack symbol has pin geometry that didn't match the
    existing wire endpoints, silently shorting both jack pins onto +5V with
    GND left discon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
    [MagicBand_BarrelJack.kicad_sch]
2026-08-05 Document front/back layout constraint, relabel barrel jack connector
    RFID+MCU stack must sit at the front (interactive/tap end) of the
    ornament; the barrel jack must be at the back. The jack itself is a
    separate panel-mount part with bare flying leads, not board-mounted --
    it connects to the board via two soldered wires, not a purchased
    connector. Relabeled J8 to PWR_IN_BarrelJack_BareLeads to make that
    explicit, and added a Physical Layout Constraint section to the PCB
    Design Plan so this isn't missed once actual placement/routing starts.
    ERC re-run clean, no regression.
    [MagicBand_BarrelJack.kicad_sch]
2026-08-05 NeoPixel headers: JST-PH connector, pin order documented
    J6/J7 changed from generic 2.54mm pin headers to JST-PH 3-pin connectors
    for easier connect/disconnect at assembly. Pin order (1=DATA, 2=+5V,
    3=GND) confirmed identical on both headers via netlist before the swap,
    and documented in PCB Design Plan.md since there's no external standard
    JST pin order for WS2812 strips to rely on -- the user is terminating
    both ends themselves, so this table is the source of truth.
    J3 (RF TX module) shares the same generic footprint family and was
    deliberately left untouched -- caught by an assertion check before the
    replacement ran, not something that would have been obvious from a
    find-and-replace alon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
    [MagicBand_BarrelJack.kicad_sch]
2026-08-05 Close PDR gaps: reverse-polarity protection, firmware trim, cleanup
    Adversarial PDR found one blocking issue and five should-fix items on
    PCB/MagicBand_BarrelJack/MagicBand_BarrelJack.kicad_sch. All closed:
    - Blocking: added a P-channel MOSFET (Q1, AO3401A) ideal-diode
    reverse-polarity protection circuit ahead of the regulator/MCU -- the
    barrel jack is bare wire leads with no mechanical keying, a real risk
    of a reversed or wrong-voltage adapter with nothing previously in the
    way. MOSFET chosen over a simple diode to avoid eating into the
    ATmega328P's 16MHz voltage headroom. Topology cross-checked against
    real references before committing. ERC-clean (0 errors, 209 warnings)
    aft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
    [MagicBand_BarrelJack.kicad_sch]
2026-08-05 Fix Q1 Source/Drain pin swap, close remaining review items
    Second-round adversarial review found the reverse-polarity protection
    MOSFET (Q1, AO3401A) wired backwards -- pin2 was treated as Drain, pin3
    as Source, but the real part is Pin1=Gate/Pin2=Source/Pin3=Drain per
    Alpha & Omega's own datasheet. Independently confirmed by rendering the
    actual datasheet PDF locally and reading the pin diagram directly (not
    trusting any prior claim). As wired, the circuit likely would not have
    functioned -- possibly blocking power even under correct polarity.
    Fixed by swapping which net lands on pins 2/3, verified via netlist
    export before and after (ERC alone can't catch this class of bug).
    ERC clean, no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
    [MagicBand_BarrelJack.kicad_sch]
2026-08-05 Reorganize PCB Design Plan by topic, add 40x40mm layout target
    Doc had grown into a pure chronological append-log (14 date-stamped
    sections in commit order), hard to navigate. Restructured into: active
    board (full spec, constraints, component list), firmware, a Design
    Review Methodology section documenting the practice this project
    established (every real bug found was in the ERC-passes-but-still-wrong
    gap; independent review + primary-source verification is how each was
    caught), and archived earlier boards clearly separated as reference.
    Also captures the new 40x40mm target board outline, flagged as
    aggressive given the MFRC522 module's own physical size may exceed it
    once stacked -- layou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
2026-08-05 PCB layout: 40x40mm placement achieved, routing not yet DRC-clean
    Placed all 20 components via the pcbnew Python API (no GUI available
    headless), zero courtyard overlaps, fully within the 40x40mm target --
    the user's aggressive size goal is met on placement. Swapped R1/R2/C5
    from bulky THT footprints to SMD (matching the rest of the board's
    parts) specifically to make the target achievable -- functional no-op,
    ERC re-confirmed clean.
    Routing is honestly incomplete: 139 DRC violations remain after several
    iteration rounds (down from 240 on the first naive pass). Root cause is
    real and diagnosed, not guessed -- scripted point-to-point routing can't
    reliably route around nearby unrelated pads,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
    [MagicBand_BarrelJack.kicad_pcb]
2026-08-05 Swap C5/R1/R2 to SMD footprints (was left uncommitted from layout work)
    Footprint-only change, no wiring/net impact: C5 (bulk cap) and R1/R2
    (reset pullup, gate resistor) were THT parts inconsistent with the rest
    of the board's SMD passives, swapped during PCB layout to help hit the
    40x40mm target. This commit was missed in the layout commit itself --
    caught by checking git status after, not assumed clean. ERC re-confirmed
    clean (0 errors, 209 warnings, unchanged).
    [MagicBand_BarrelJack.kicad_sch]
2026-08-05 Close layout PDR findings: keepout, J9 reposition, mounting holes, silkscreen
    Real fixes, honestly reported alongside the DRC delta (139 -> 202
    violations -- see PCB Design Plan for full breakdown of why the count
    went up despite genuine progress on every item):
    - RF antenna keepout properly defined on both copper layers, sized to
    J3's actual footprint + margin; 4 offending track segments (not just
    the 1 originally flagged) rerouted around it
    - J9 (ISP header) moved from the wrong side of the board entirely to
    directly adjacent to J2/U1 -- a real placement win, though the manual
    reconnection routing didn't yet capture the benefit (measured trace
    lengths came out longer, not shorte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
    [MagicBand_BarrelJack.kicad_pcb]
2026-08-05 Add GUI-routing handoff note: DRC breakdown, confirmed mounting-hole conflicts
    FreeRouting confirmed not viable (kicad-cli has no DSN export in 10.0.5,
    GUI-only feature) -- user routing manually instead. Categorizes the 202
    current DRC violations (routing-artifact vs. needs-explicit-attention),
    and confirms the npth_inside_courtyard discrepancy flagged in review was
    real: MH1/MH3 do overlap connector courtyards, only MH2 is clear.
    Deliberately left the mounting-hole fix for the GUI session rather than
    another blind headless coordinate edit.
2026-08-06 Fold KiCad setup into the Dev Environment Setup recovery runbook
    Consolidates KiCad AppImage install/launch steps (previously only in
    PCB Design Plan.md) into Technical Reference's full-recovery runbook,
    alongside the existing Arduino toolchain steps. Also corrects a
    repeated-but-wrong claim that the AppImage has no bundled footprint
    library -- verified today that usr/share/kicad/{symbols,footprints}
    are both present locally. Adds two verified toolchain dead-ends
    (no pcbnew module, no headless Specctra DSN export) to the existing
    dead-ends list.
    Claude-Session: https://claude.ai/code/session_01WRfsGJdmccHFit2MbdKbSy
2026-08-06 Document WSLg GPU-passthrough rendering bug in KiCad launch
    Default hardware-OpenGL launch froze the window and made the mouse
    disappear on hover -- a WSLg GPU-passthrough glitch, not an app hang.
    LIBGL_ALWAYS_SOFTWARE=1 fixed it immediately. Updated the KiCad launch
    command to use it by default and added a dead-ends entry.
    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
2026-08-06 Log first KiCad GUI session: WSLg fixes, FreeRouting autorouter, live routing
    First hands-on GUI session for this board. Fixed two WSLg rendering
    bugs (GPU passthrough, canvas-freeze), got the FreeRouting autorouting
    path working end-to-end for the first time (blocked since 2026-08-05
    on headless DSN export), and ran it: 34 unrouted nets -> 2, DRC down
    from 202 violations to 31. Board file itself is NOT saved to disk yet
    -- deliberately left for the user to save/commit once satisfied.
    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
2026-08-06 Drop inner NeoPixel ring, single LED strip only; correct FreeRouting result as lost not pending
    User is sourcing a single LED strip (outer position) instead of the
    original two-ring design -- no second/inner ring. Updated firmware
    (MagicBand_BarrelJack.ino, compiles clean, smaller footprint) and all
    docs that were safe to touch without conflicting with the then-open
    KiCad session. Schematic/PCB (removing J7, renaming J6) deliberately
    deferred to next session -- do via GUI schematic editor, not another
    headless edit, and do it before re-running FreeRouting.
    Also corrects last commit's framing: the FreeRouting DRC-31 result
    was closed without saving and is actually lost, not just pending --
    o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
    [MagicBand_BarrelJack.ino]
2026-08-06 Remove J7 (inner NeoPixel ring) from schematic and PCB, verified clean
    Completes the LED-strip scope change deferred at the end of the last
    session. Removed J7 (component, D6 wiring, its dedicated power
    symbols) from the schematic, its footprint plus 2 dangling track
    stubs from the PCB, and renamed J6's value to NeoPixel_LED_Strip
    (count-agnostic, pending the ordered strip).
    Verified via kicad-cli, not assumed: ERC 0 errors (129 warnings, down
    from 209, all pre-existing cosmetic), DRC 0 unconnected pads / 0
    footprint errors (188 violations, down from 202). Confirmed side
    benefit: npth_inside_courtyard dropped 3->2, the MH3/J7 courtyard
    conflict is gone. Regenerated all tracked exports (ERC/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
    [MagicBand_BarrelJack.kicad_pcb, MagicBand_BarrelJack.kicad_sch]
2026-08-07 Finalize PCB placement: fix MH3/J6 courtyard conflict, silkscreen label overlaps
    Moves MH3 clear of J6's courtyard (the one error-level placement issue),
    nudges R1/C4 reference fields off neighboring silkscreen/pads. Net DRC:
    188 -> 176 violations. U2/J2 label overlap left open, needs GUI (see
    Session Log). Also stashed a stale-base uncommitted change found in the
    main checkout and logged a PM process suggestion about pulling before
    trusting local git state.
    Claude-Session: https://claude.ai/code/session_01UiULxbNnG293uuE4csn9nG
    [MagicBand_BarrelJack.kicad_pcb]
2026-08-10 Placement cleanup: reposition J8, fix U2/J2 silkscreen, remove J3 antenna keepout
    Ripped up leftover tracks/vias from the earlier unsaved routing attempt and
    refilled copper zones. DRC violations 176 -> 4 (remaining are cosmetic:
    MH1 silk-edge clip, 3 pre-existing footprint-library path warnings).
    42 unconnected pads is expected -- board has no routing yet.
    Deleted J3's antenna keepout zone so FreeRouting can place vias/tracks near
    it; will keep other copper off the antenna's near-field manually instead.
    [MagicBand_BarrelJack.kicad_pcb]
2026-08-10 PM: log placement/pre-route cleanup GUI session, update progress count
    Documents J8 reposition, U2/J2 silkscreen fix, J3 keepout removal, stale
    track/via cleanup, and the KiCad launch quirks in this environment
    (AppImage location, FUSE unavailable, sandbox blocking X11 socket).
2026-08-10 FreeRouting pass: board fully routed, 0 unconnected nets
    Exported Specctra DSN (GUI), ran FreeRouting headlessly (jar + JDK 25 JRE,
    -de/-do/-mp 50), imported the resulting .ses back in KiCad, refilled zones.
    DRC: 4 -> 52 (mid-import, stale zone fill) -> 8 after refill. Remaining 8:
    4 pre-existing cosmetic (MH1 silk-edge clip, 3 footprint-library path
    warnings) + 4 real starved-thermal/GND-pour bonding issues at J9 pad 6,
    U1 pads 8 and 22, J2 pad 6 -- left for a follow-up GUI session.
    [MagicBand_BarrelJack.kicad_pcb]
2026-08-10 PM: log FreeRouting pass (board fully routed), update progress count
    Documents the headless FreeRouting invocation (JDK 25 JRE required),
    the 42->0 unrouted net result, and the 4 real starved-thermal GND
    issues left for next session.
2026-08-10 GND thermal fixes: J2 pad 6 resolved, partial progress on J9/U1
    Set J2 pad 6, J9 pad 6, and U1 pad 22 to solid zone connection (GUI).
    DRC: 8 -> 6 violations. J2 pad 6 fully resolved. J9 pad 6's thermal
    issue cleared but it's still unconnected (separate root cause, likely
    an isolated GND pour fragment rather than a broken track). U1 pad 22
    unchanged -- solid setting may not have saved for this pad. U1 pad 8
    unchanged (isolated island, untouched this pass).
    [MagicBand_BarrelJack.kicad_pcb]
2026-08-10 PM: log GND thermal fix pass, split remaining GND items, update progress
    J2 pad 6 fully resolved. J9/U1 pad 22/U1 pad 8 remain open with the
    user's working theory logged for J9 (isolated pour fragment, not a
    broken track). User pausing here to research PCB fundamentals.
2026-08-10 PM: dedupe WP3.1 line, document the FreeRouting CLI recipe
    Removed an accidental duplicate line from the last GND-fix session log.
    Added the "FreeRouting (autorouter)" section to Technical Reference --
    several WP entries already referenced it but it never existed. Also
    migrated freerouting.jar and the JDK 25 JRE from ephemeral /tmp to
    ~/.local/opt/ so the environment survives a reboot.
2026-08-11 J9: reassign footprint to shrouded IDC-6 box header (schematic only)
    Switched J9's footprint field from a plain PinHeader_2x03 to
    Connector_IDC:IDC-Header_2x03_P2.54mm_Vertical -- a keyed/shrouded
    box header, so future ISP programming uses a foolproof ribbon-cable
    connector instead of 6 loose jumper wires. ERC still 0 errors /
    129 pre-existing warnings, unaffected.
    PCB-side placement NOT done here: the shrouded part's physical body
    is much larger than the plain header (~10x16mm incl. shroud) and
    does not fit at J9's current position (9,4) -- it would overhang the
    board's top edge by ~1.6mm and crowd J2's courtyard. Needs a GUI
    reposition + reroute of 6 short nets (D11/D12/D13/RESET/+5V/GND)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
    [MagicBand_BarrelJack.kicad_sch]
2026-08-11 PM: log J9 shrouded-header footprint reassignment, update progress
    Schematic-side swap done and ERC-verified clean. PCB-side placement
    left open with the exact fit problem documented (board-edge overhang,
    J2 courtyard proximity) so it's not re-discovered from scratch.
2026-08-11 Doc: FreeRouting GUI-popup gotcha that silently blocks headless runs
    Found live: a run took 7 minutes longer than expected between
    "routing complete" and the .ses actually being written, because
    FreeRouting popped up a data-collection consent dialog (gui.enabled
    was true) that just sat there until dismissed by hand -- no error,
    no timeout. Documented the config fix (gui.enabled/telemetry/contact
    = false) so it doesn't silently stall a future unattended run.
2026-08-11 J9 relocated for shrouded header, re-routed, board fully connected again
    J9 moved to a spot with room for the IDC shrouded box header footprint,
    old tracks/vias cleared, fresh DSN exported and FreeRouting re-run
    (42 -> 0 unrouted, ~2.3s). Zones refilled.
    DRC: 6 violations, same 3 real GND issues as before the move (J9 pad 6,
    U1 pad 22, U1 pad 8) plus the same 4 pre-existing cosmetic warnings --
    nothing new introduced by the reposition. J2 pad 6's earlier fix held.
    [MagicBand_BarrelJack.kicad_pcb]
2026-08-11 PM: log J9 shrouded-header swap/relocate/reroute session
    Documents the F8 duplication bug (root cause + do-not-use), the
    FreeRouting GUI-popup gotcha, and current GND pad status after the
    full reroute. Progress count updated.
2026-08-11 Manual reroute resolves U1 pad 22 and J9 pad 6, board fully connected
    User manually rerouted the affected nets using layer-swap (V mid-route)
    after FreeRouting stalled at 6 unrouted following a placement move.
    Fresh DSN exported, FreeRouting confirmed 0 unrouted nets to add.
    Session imported, zones refilled.
    DRC: 6 -> 5 violations, 3 -> 1 unconnected. U1 pad 22 and J9 pad 6 are
    both resolved. Only U1 pad 8 (isolated island) remains from the
    original 3 real GND issues, plus the same 4 pre-existing cosmetic
    warnings (MH1 silk-edge clip, 3 footprint-library path warnings).
    [MagicBand_BarrelJack.kicad_pcb]
2026-08-12 U1 pad 8 bridged to main GND pour, board 0 unconnected pads
    Manual short track from pad 8 to the adjacent valid pour region,
    bridging the isolated-island gap. DRC: 0 unconnected pads (all 3
    original GND connectivity issues now resolved). 5 violations remain,
    all pre-existing cosmetic (MH1 silk-edge clip, 3 footprint-library
    path warnings) plus a residual starved-thermal/isolated-island flag
    on pad 8 -- the pad-to-pour bond itself is still non-ideal since the
    fill geometry wasn't recomputed, but the net is electrically complete
    via the bridging track. Not a functional defect.
    [MagicBand_BarrelJack.kicad_pcb]
2026-08-12 PM: log U1 pad 8 fix -- all 3 GND connectivity issues now resolved
    Board has 0 unconnected pads. Only cosmetic pre-existing warnings and
    one residual (non-functional) pour-fill flag remain. Progress updated.
2026-08-12 Fix MH1 silkscreen clipped at board edge
    DRC: 5 -> 4 violations. Remaining: 3 mounting-hole footprint-library
    path warnings (cosmetic, harmless) and the residual U1 pad 8
    starved-thermal flag (non-functional, net already electrically
    complete). 0 unconnected pads.
    [MagicBand_BarrelJack.kicad_pcb]
2026-08-12 PM: log MH1 silkscreen fix in today's session entry
2026-08-12 Center U1, fix orientation-label text height, widen mounting-hole margin
    Applied PDR should-fix items: bumped "Right"/"Top" silkscreen labels
    to 1mm height (was 0.75mm, under the min-text-height rule and typical
    fab legibility floor -- stroke width left at 0.1mm, not bumped to the
    recommended 0.15mm, worth revisiting); re-centered U1 for max edge
    clearance both directions (front/back placement constraint deemed not
    load-bearing here, per user); moved MH1-3 for ~2.4mm min edge margin
    (up from ~1.4mm).
    Cleared all tracks/vias for the U1 move, re-ran FreeRouting (42 -> 0
    unrouted, ~2.3s), imported, refilled.
    DRC: U1 pad 8 (starved-thermal/isolated island) and U1 pad 22
    (unconnected) recurred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
    [MagicBand_BarrelJack.kicad_pcb]
2026-08-12 PM: log adversarial PDR #2 findings and this session's decisions
    Documents the blocking RF-antenna-keepout finding (deferred per user
    decision), the U1-front-constraint drop, text/mounting-hole fixes,
    and the recurring U1 pad 8/22 GND issues after the recenter. Progress
    count updated.
2026-08-12 U1 pad 8 and pad 22 bridged again, board DRC-clean except cosmetics
    Manual GND bridge tracks at U1's new (centered) position, same fix
    as before. DRC: 5 -> 3 violations, 1 -> 0 unconnected. Only the 3
    pre-existing footprint-library path warnings remain (MH1-3, cosmetic,
    not fixable from the GUI). The silk_overlap between the "Right" label
    and U1's outline from the recenter is also gone.
    [MagicBand_BarrelJack.kicad_pcb]
2026-08-12 PM: log U1 pad 8/22 re-fix -- board DRC-clean except cosmetics
    Progress count updated. Carrying forward the remaining optional
    items (stroke width, deferred antenna risk, design-plan doc update).
2026-08-12 PCB Design Plan: drop MCU-at-front constraint, correct false self-report
    Per user decision (2026-08-12): U1 no longer needs to be paired with
    J2 at the ornament's front. Also corrects 1.7's placement-compliance
    claim, which the second adversarial PDR found was never actually true
    for U1 -- and flags the section's DRC-status numbers as stale, pointing
    to Session Log as the current source of truth instead of letting this
    doc silently drift further out of sync.
2026-08-13 Y1 relocated for edge clearance, manual track cleanup, board reconnected
    User moved Y1 (crystal) off the right edge (was ~0.70mm margin, flagged
    by PDR #3) and manually cleaned up duplicate tracks + finished routing
    by hand -- no FreeRouting import used this round, all done directly in
    the GUI.
    DRC: 0 unconnected pads. 4 violations remain: 3 pre-existing cosmetic
    footprint-library warnings, 1 residual starved-thermal flag on U1 pad
    8 (same cosmetic-only situation confirmed previously -- net is
    electrically complete).
    [MagicBand_BarrelJack.kicad_pcb]
2026-08-13 PM: log PDR #3, fix axis-convention mixup, log Y1 relocation
    Documents the false-positive J2 finding (front/back is X-axis, not Y
    -- corrected in PCB Design Plan for future reviews), Y1's edge-margin
    fix, duplicate-track cleanup, and 2 small remaining housekeeping items
    (dangling D6 label, misapplied pad-2 override). Progress updated.
2026-08-13 Remove 183 duplicate track segments via Route > Cleanup Tracks and Vias
    A programmatic scan (start/end/layer/net comparison) found roughly
    half the board's routing existed as exact duplicate overlapping
    segments -- 183 of 367 total, far more than the single duplicate at
    U1 pad 8 caught by PDR #3. Likely accumulated across several
    FreeRouting-import + manual-routing passes where new tracks were
    added alongside old ones instead of replacing them.
    Cleanup run with "delete redundant tracks" + "merge co-linear
    segments" + "delete dangling tracks" enabled. Verified: 367 -> 183
    segments, 0 duplicates remaining. DRC unchanged (0 unconnected pads,
    4 harmless violations) -- connectivity fully intact.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
    [MagicBand_BarrelJack.kicad_pcb]
2026-08-13 Widen J8->Q1 power input leg to 0.5mm, revert the rest to standard 0.2mm
    PDR #4 flagged the +5V path as uniformly 0.2mm with no widened power
    trunk. Widening the whole net caused 26 DRC violations (mostly
    clearance) -- board is too dense for a uniformly wider +5V net without
    a real reroute. Kept the widen on just the J8->Q1 raw input leg (clean,
    no violations); reverted the U2-regulator branch and the J6/LED trunk
    back to 0.2mm.
    User's call: LED strip draw is modest with a forgiving duty cycle, not
    sustained full-brightness -- 0.2mm at 1oz copper (~0.7-1A continuous)
    has real headroom for that load profile. Not worth fighting the
    board's density for more width here.
    DRC: back to the standa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
    [MagicBand_BarrelJack.kicad_pcb]
2026-08-13 Regenerate board SVGs for final trace-width state
2026-08-13 PM: log duplicate-track cleanup, PDR #4, J8 decision, trace widths
    Documents the 183-duplicate-segment find/fix, PDR #4's real J8
    placement finding (dropped, same reasoning as U1), the trace-width
    experiment and revert, and closes out the stale pad-2 override item.
    Design plan flagged as having wrong self-reported placement claims
    3 of the last 4 review rounds. Progress count updated.
2026-08-13 PM: close stale WP4.1 duplicate lines (PCB layout, shell dimensions)
    Both were already tracked and done elsewhere in the document -- these
    leftover unchecked duplicates were actively misleading for assessing
    build-readiness.
2026-08-13 PM: log PDR #5 clean bill of health, fab-readiness assessment
    Documents the fifth adversarial review (0 blocking, 0 should-fix),
    the RF TX module footprint gate found outside the PCB-only PDR scope,
    and a new PM Improvement Suggestion about Phase 3/4 WP mislabeling.
    Progress count updated.
2026-08-17 Add BOM for barrel-jack custom PCB variant
    Compiled from PCB/MagicBand_BarrelJack schematic, PCB Design Plan, and
    Technical Reference — no standalone BOM existed for this active build
    (only the paused wireless variant had one).
2026-08-17 Reorganize barrel-jack BOM into two-level (subassembly/part) structure
    Groups parts under Level 1 subsystems (Core MCU Circuit, RFID, RF
    Control, Lighting, Programming Interface, Power, Fabrication) with
    Level 2 line items and per-subassembly subtotals.
2026-08-17 Restructure BOM into proper 3-level assembly hierarchy
    Level 1: PCB Assembly, RF Outlet, Power Supply, Programmer (top-level
    items into the ornament). Level 2: what's soldered/plugged onto the
    board (bare PCB, MFRC522, RF TX, NeoPixels, ISP header, barrel jack).
    Level 3: components populated on the bare board (MCU, crystal, caps,
    protection MOSFET, regulator).
2026-09-15 Close out stale relay/floor-box tasks superseded by RF-outlet pivot
    Project Overview's Summary and Scope, and Work Packages Phase 2 (WP2.1,
    WP2.2), still described/tracked the mains relay + floor power box design
    that was replaced by a 433MHz RF outlet back on 2026-06-16 (see Decisions
    Log). Those two Work Packages items sat open for ~2 months and were
    surfacing as stale "next steps" on the project dashboard.
    Claude-Session: https://claude.ai/code/session_01P5bYmzEWonKT2eaadthfbE
